reichenberger/SyringePump/README.md

# SyringePump
Open-source syringe pump design.

To be added:
- description
- fabrication instructions
