reichenberger/SyringePump/OpenSCAD_design/body_up.stl

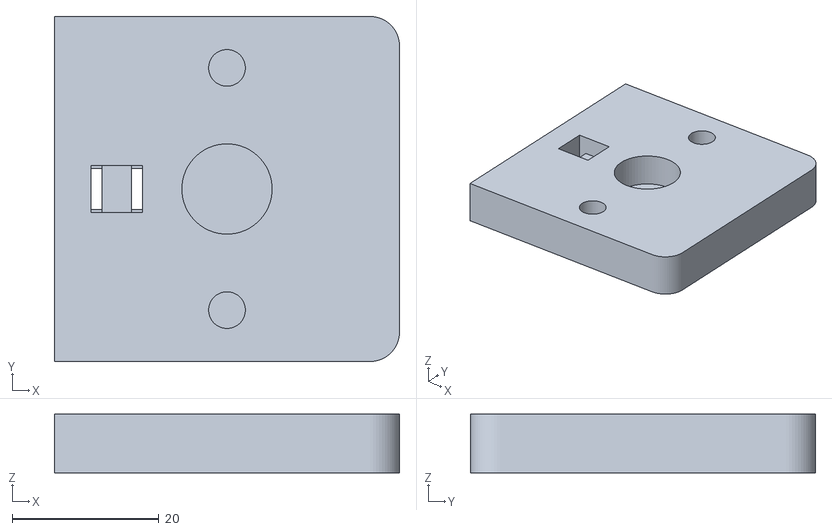
[picture p25: CAD file, 2017-06-12]
OpenSCAD_design/body_up.stl
47.0 x 47.0 x 8.00
