reichenberger/SyringePump/OpenSCAD_design/enclosure_electronics.stl

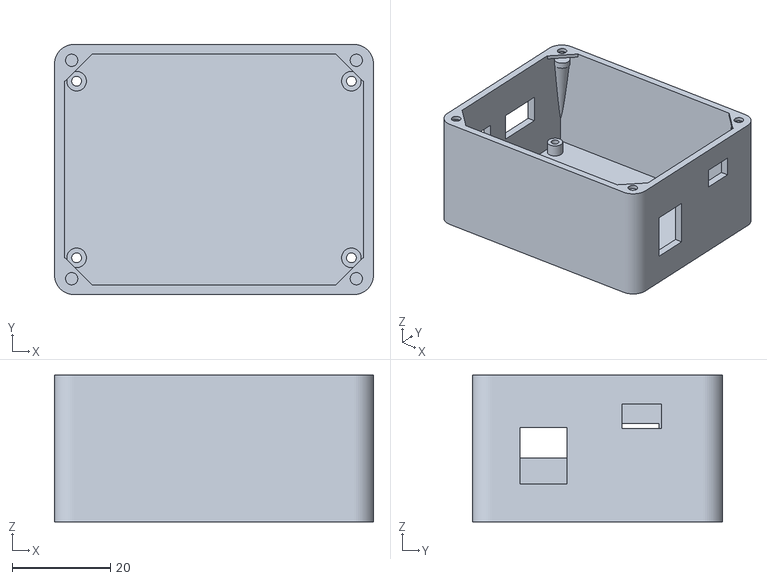
[picture p26: CAD file, 2017-06-12]
OpenSCAD_design/enclosure_electronics.stl
65.0 x 51.0 x 29.9
