reichenberger/SyringePump/OpenSCAD_design/side_wall.stl

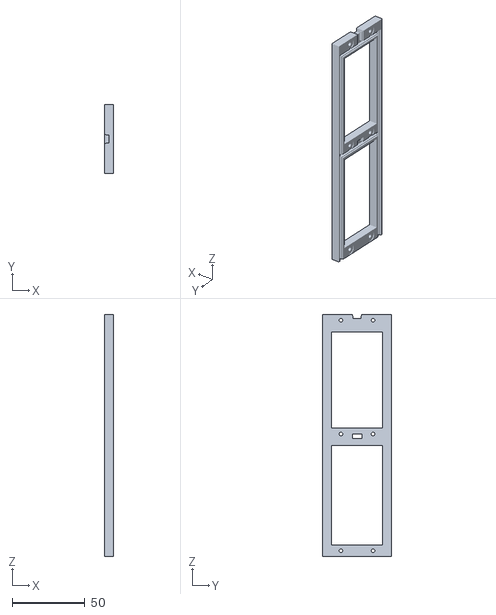
[picture p27: CAD file, 2017-06-12]
OpenSCAD_design/side_wall.stl
6.00 x 47.0 x 166.0
