reichenberger/SyringePump/OpenSCAD_design/stepper_mount.stl

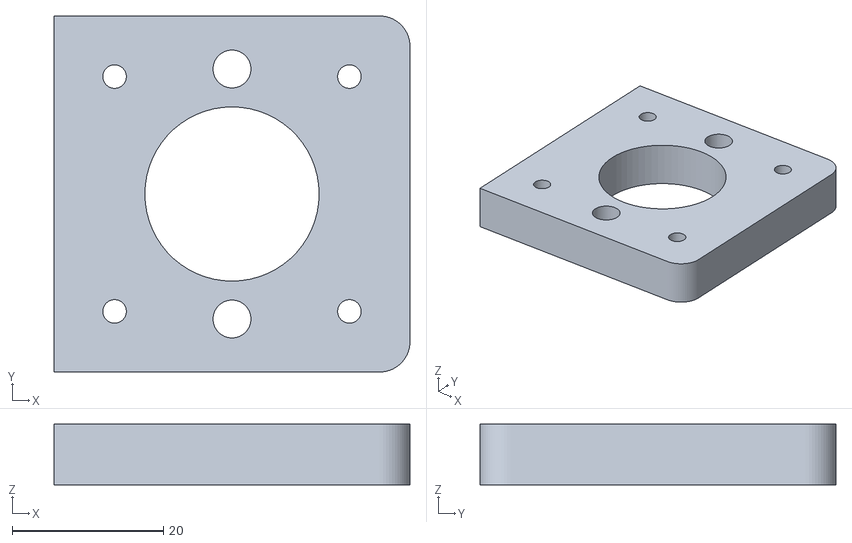
[picture p28: CAD file, 2017-06-12]
OpenSCAD_design/stepper_mount.stl
47.0 x 47.0 x 8.00
