reichenberger/SyringePump/OpenSCAD_design/mount_down.stl

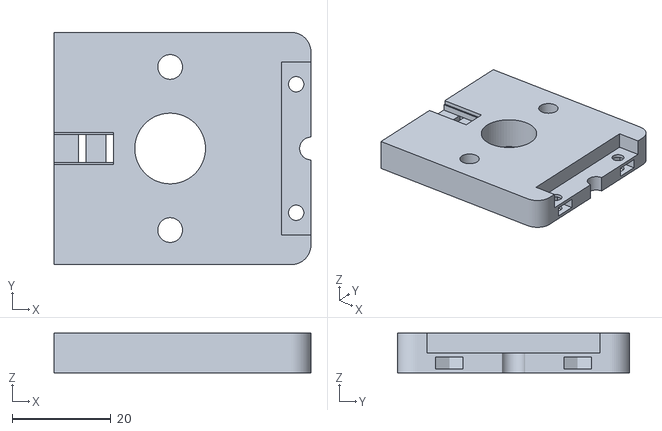
[picture p29: CAD file, 2017-06-12]
OpenSCAD_design/mount_down.stl
52.0 x 47.0 x 8.00
