reichenberger/SyringePump/OpenSCAD_design/body_down.stl

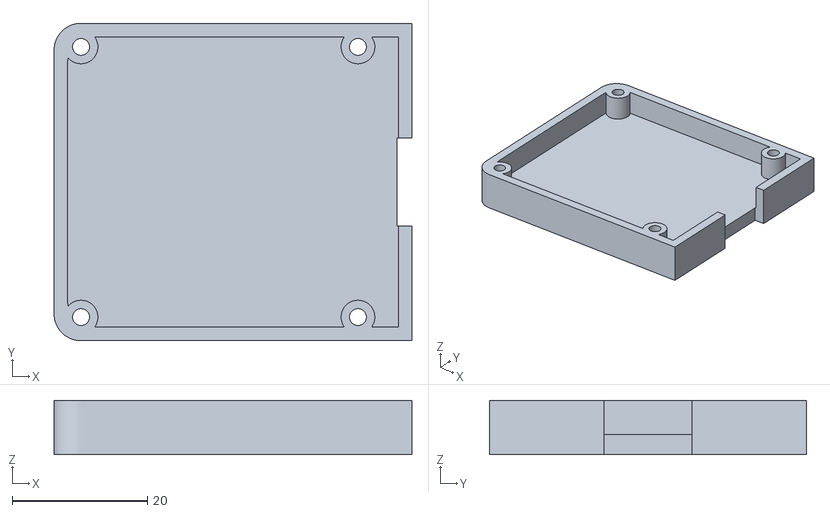
[picture p30: CAD file, 2017-06-12]
OpenSCAD_design/body_down.stl
53.0 x 47.0 x 8.00
