reichenberger/SyringePump/OpenSCAD_design/side_wall_enclosure.stl

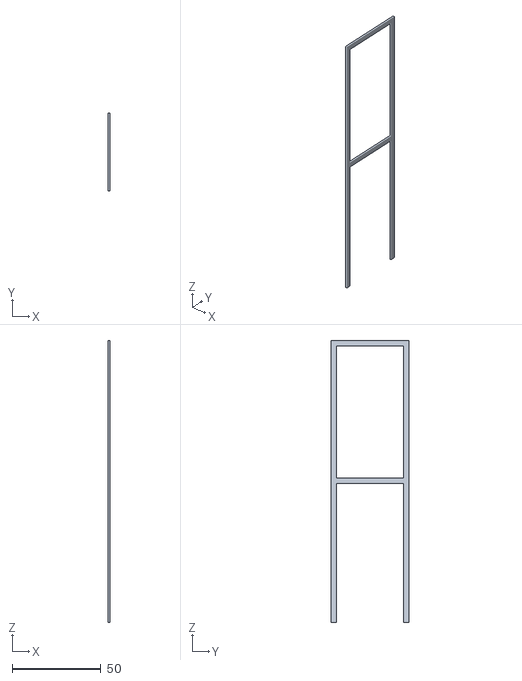
[picture p31: CAD file, 2017-06-12]
OpenSCAD_design/side_wall_enclosure.stl
1.00 x 44.0 x 159.0
