reichenberger/SyringePump/OpenSCAD_design/moving_part.stl

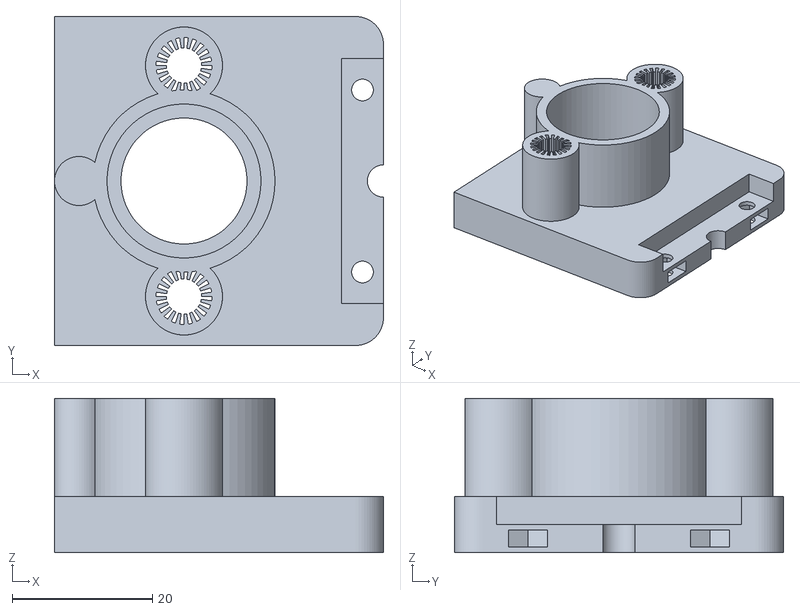
[picture p32: CAD file, 2017-06-12]
OpenSCAD_design/moving_part.stl
47.0 x 47.0 x 22.0
