reichenberger/SyringePump/OpenSCAD_design/stepper_cover.stl

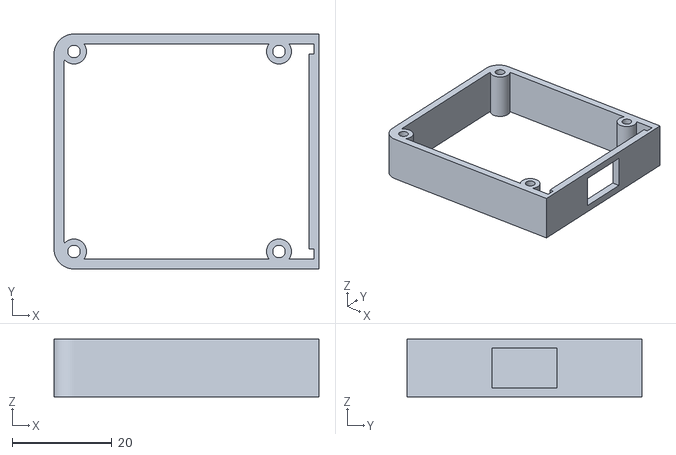
[picture p33: CAD file, 2017-06-12]
OpenSCAD_design/stepper_cover.stl
53.0 x 47.0 x 11.6
