reichenberger/SyringePump/(list of files, cad)

Other CAD files:
OpenSCAD_design/tightening_plate_up.scad
